cyx3705/2026-003/b-Picture/机械装配图.jpg

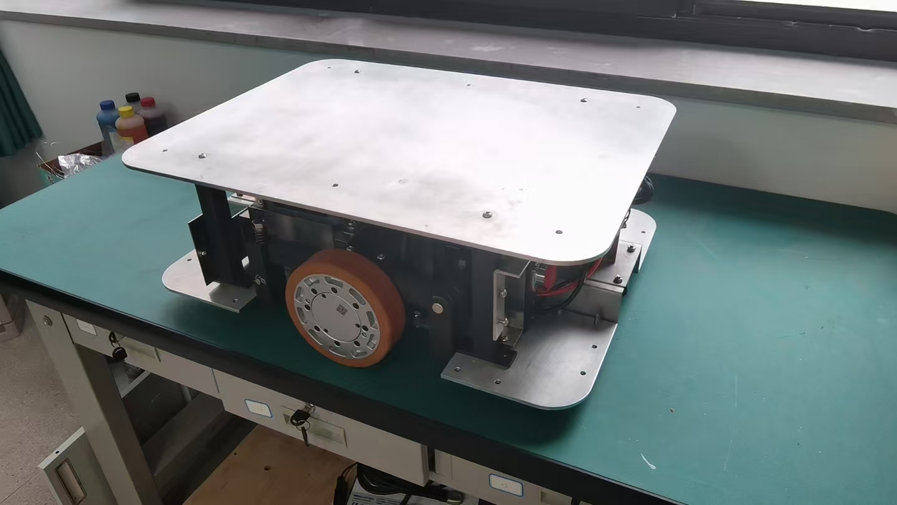
b-Picture/机械装配图.jpg
