cyx3705/2026-003/b-Picture/初次装配图.jpg

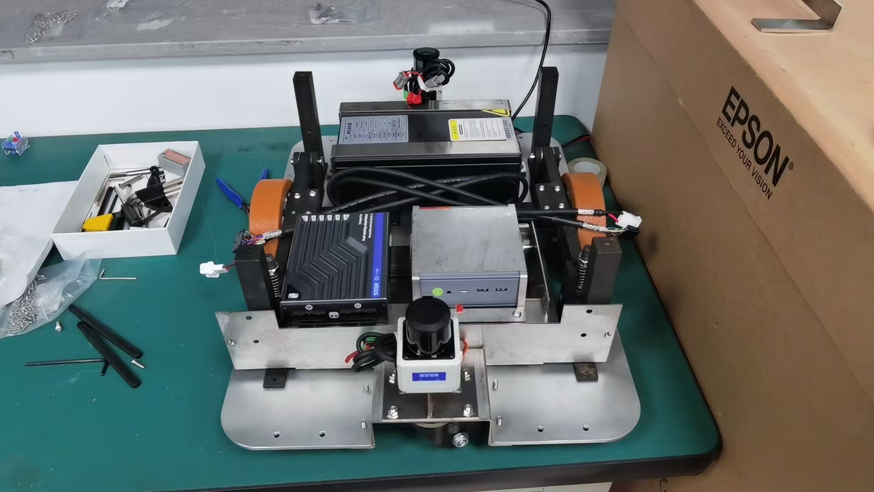
b-Picture/初次装配图.jpg
