cyx3705/2026-003/b-Office/电气接线任务书.md

## 电气接线计划

- 上位机接线图画下 
- 电气缺件BOM统计
- 电气接线接口缺失复核一下
-
