cyx3705/2026-003/b-EPLAN/AGV.edb/Images/2.png

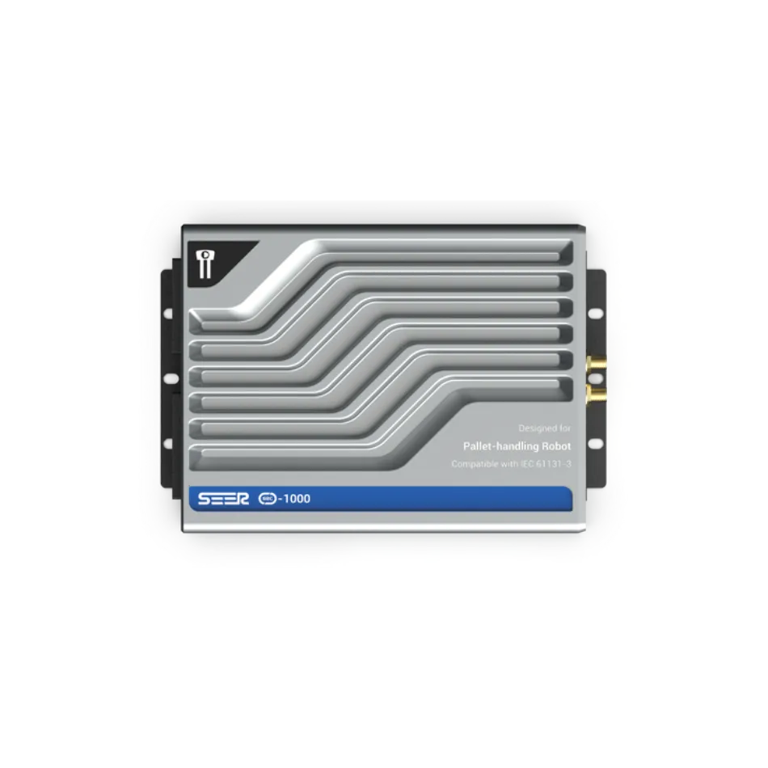
b-EPLAN/AGV.edb/Images/2.png
