cyx3705/2026-003/b-EPLAN/AGV.edb/Images/CRC3000.png

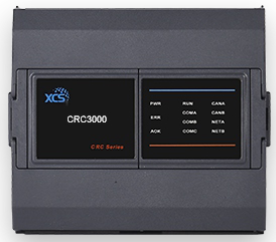
b-EPLAN/AGV.edb/Images/CRC3000.png
