cyx3705/2026-003/b-EPLAN/AGV.edb/Images/EPLAN.jpg

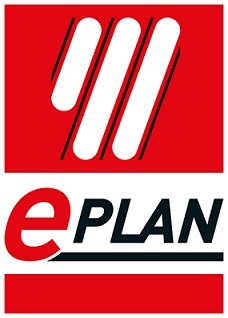
b-EPLAN/AGV.edb/Images/EPLAN.jpg
