cyx3705/2026-003/b-Picture/效果图.png

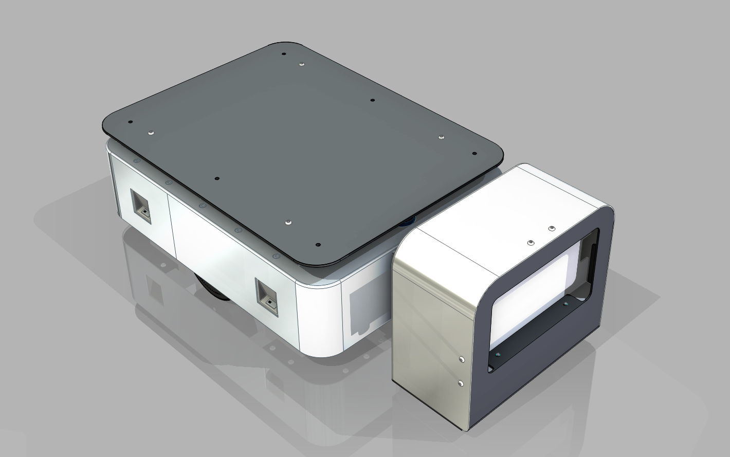
b-Picture/效果图.png
