cyx3705/2026-003/b-Office/BOM表.xlsx

Sheet: Revision History
Revision 版本 | Description 变更描述 | Date 变更日期 | Updated BY 变更人 | Remarks 备注

Sheet: BOM模板
 | Product Name 成品名称 |  | DOC. Number 文件编号 |  | Rev. 版本号 |  |  | Updated BY 更新人 |  | Checked BY 审核人 |  | Approved BY 批准人
 |  |  | BOM-503TWM0203 |  | 1.00
 |  |  |  |  |  |  |  | Date 日期 |  | Date 日期 |  | Date 日期
 |  |  | Initial Date 初版日期
Item 序号 | 文档号 | Description 名称 | Specification 参数描述 | Manufacturer 制造商 |  | Material 材料 | QTY 数量 | Unit 单位 | 是否验收 | Remarks 备注 | EPDM Auto EPDM自动导出 | 细则 | Unit Price 单价(RMB) | Subtotal 合计(RMB)
 |  |  |  | Model No. 型号 | Brand 品牌
1 | 1121 | 1121-底盘主体 |  |  |  | 铝 | 1 | 个 |  | 【淘宝】https://e.tb.cn/h.7ml5gZPPQkVISMc?tk=tJbsUfdvDEd CZ005 |  |  |  | 加工件统一计价
2 | 2122 | 2122-架子 |  |  |  | 钢 | 4 | 个 |  | 【淘宝】https://e.tb.cn/h.7ml5gZPPQkVISMc?tk=tJbsUfdvDEd CZ006 |  |  |  | 加工件统一计价
3 | 1113 | 1113-内六角平圆头螺钉-GBT70.2-2015_M6X16 | M6*16 |  |  |  | 34 | 个 | 对 | 已经购买 |  |  |  | 已经购买
4 | 1312 | 1312-内六角平圆头螺钉-GBT70.2-2015_M6X10 | M6*10 |  |  |  | 14 | 个 | 对 | 已经购买 |  |  |  | 已经购买
5 | 1221 | 1221-前桥 |  |  |  | 钢 | 2 | 个 |  | 【淘宝】https://e.tb.cn/h.7ml5gZPPQkVISMc?tk=tJbsUfdvDEd CZ006 |  |  |  | 加工件统一计价
6 | 1222 | 1222-后桥 |  |  |  | 钢 | 2 | 个 |  | 【淘宝】https://e.tb.cn/h.7ml5gZPPQkVISMc?tk=tJbsUfdvDEd CZ006 |  |  |  | 加工件统一计价
7 | 1213 | 1213-大垫圈 | 10*30*2 |  |  |  | 1 | 组 |  | 【淘宝】假一赔四 https://e.tb.cn/h.7MJcgNyqDq0lb4x?tk=nxhCUgh63I7 CZ193 「304不锈钢垫片圆形加大加厚金属螺丝平垫圈超薄介子华司平垫大全」 点击链接直接打开 或者 淘宝搜索直接打开 |  | 5个 | 1.13元 | 1.13元
8 | 1224 | 1224-减震器 |  |  |  | 钢 | 2 |  |  | 【淘宝】https://e.tb.cn/h.7ml5gZPPQkVISMc?tk=tJbsUfdvDEd CZ006 |  |  |  | 加工件统一计价
9 | 1214 | 1214-小垫圈 |  |  |  |  | 1 | 组 |  | 【淘宝】假一赔四 https://e.tb.cn/h.7MJcgNyqDq0lb4x?tk=nxhCUgh63I7 CZ193 「304不锈钢垫片圆形加大加厚金属螺丝平垫圈超薄介子华司平垫大全」 点击链接直接打开 或者 淘宝搜索直接打开 |  | 5个 | 1.58元 | 1.58元
10 | 1218 | 1218-弹簧 |  |  |  |  | 2 | 个 |  | 【淘宝】退货运费险 https://e.tb.cn/h.7Lm8guSC0Ux0SfB?tk=6AuNUghRivr CZ028 「进口模具弹簧高强度耐高温矩形扁线压缩磨具压簧黄蓝红绿棕褐茶色」 点击链接直接打开 或者 淘宝搜索直接打开 |  |  | 2.73元 | 5.46元
11 | 1225 | 1225-左梁 |  |  |  | 钢 | 1 | 个 |  | 【淘宝】https://e.tb.cn/h.7ml5gZPPQkVISMc?tk=tJbsUfdvDEd CZ006 |  |  |  | 加工件统一计价
12 | 1215 | 1215-平头圆柱销 | 直径10x45 |  |  |  | 1 | 组 |  | 【淘宝】大促价保 https://e.tb.cn/h.7mOc2Ra9KZEBda1?tk=7f3aUfWpWek |  | 5个 | 7.05元 | 7.05元
13 | 1212 | 1212-销 | 直径8 |  |  |  | 1 | 组 |  | 【淘宝】大促价保 https://e.tb.cn/h.7mOc2Ra9KZEBda1?tk=7f3aUfWpWek |  | 5个 | 4.37元 | 4.37元
14 | 1217 | 1217-内六角平圆头螺钉-GBT70.2-2015_M6X20 | M6*20 |  |  |  | 8 | 个 | 对 | 已经购买 |  |  |  | 已经购买
15 | 1218 | 1218-内六角平圆头螺钉-GBT70.2-2015_M5X16 | M5*16 |  |  |  | 8 | 个 | 对 | 已经购买 |  |  |  | 已经购买
16 | 1216 | 1216-1型全金属六角锁紧螺母-GBT6184-2000_M10 | M10 |  |  |  | 2 | 个 | 对 | 已经购买 |  |  |  | 已经购买
17 | 1223 | 1223-右梁 |  |  |  |  | 1 | 个 |  | 【淘宝】https://e.tb.cn/h.7ml5gZPPQkVISMc?tk=tJbsUfdvDEd CZ006 |  |  |  | 加工件统一计价
18 | 1521 | 1521-安装板 |  |  |  |  | 1 | 个 |  | 【淘宝】https://e.tb.cn/h.iJUYQFq3IH6uaaV?tk=fsBd5SyIRlW | 1899-12-31 |  |  | 钣金统一计价
19 | 1515 | 1515-内六角平圆头螺钉-GBT70.2-2015_M4X8 | M4*8 |  |  |  | 6 | 个 | 对 | 已经购买 |  |  |  | 已经购买
20 | 1516 | 1516-内六角平圆头螺钉-GBT70.2-2015_M3X8 | M3*8 |  |  |  | 2 | 个 | 对 | 已经购买 |  |  |  | 已经购买
21 | 1522 | 1522-电脑安装板 |  |  |  |  | 1 | 个 |  | 【淘宝】https://e.tb.cn/h.iJUYQFq3IH6uaaV?tk=fsBd5SyIRlW | 1899-12-31 |  |  | 钣金统一计价
22 | 1577 | 1517-内六角平圆头螺钉-GBT70.2-2015_M6X12 | M6*12 |  |  |  | 18 | 个 | 对 | 已经购买 |  |  |  | 已经购买
23 | 1411 | 1411-底轮 |  |  |  |  | 2 | 个 |  | 【淘宝】大促价保 https://e.tb.cn/h.7MJ4SWmHd5yGuXb?tk=qO5IUghjzTA CZ028 「1寸重型万向轮 低重心尼龙脚轮 2寸双轮轱辘 3寸推车带刹加重轮子」 点击链接直接打开 或者 淘宝搜索直接打开 |  |  | 20.2元 | 40.4元
24 | 1421 | 1421-底轮安装板 |  |  |  |  | 2 | 个 |  | 【淘宝】https://e.tb.cn/h.iJUYQFq3IH6uaaV?tk=fsBd5SyIRlW | 1899-12-31 |  |  | 钣金统一计价
25 | 1621 | 1621-导航雷达安装板 |  |  |  |  | 1 | 个 |  | 【淘宝】https://e.tb.cn/h.iJUYQFq3IH6uaaV?tk=fsBd5SyIRlW |  |  |  | 钣金统一计价
26 | 1713 | 1713-1型非金属嵌件六角锁紧螺母-GBT889.1-2015_M6 | M6 |  |  |  | 8 | 个 | 对 | 已经购买 |  |  |  | 已经购买
27 | 1712 | 1712-内六角平圆头螺钉-GBT70.2-2015_M3X10 | M3*10 |  |  |  | 8 | 个 | 对 | 已经购买 |  |  |  | 已经购买
28 | 1721 | 1721-避障雷达安装板 |  |  |  |  | 1 | 个 |  | 【淘宝】https://e.tb.cn/h.iJUYQFq3IH6uaaV?tk=fsBd5SyIRlW | 1899-12-31 |  |  | 钣金统一计价
29 | 2121 | 2121-安装板 |  |  |  |  | 1 | 个 |  | 【淘宝】https://e.tb.cn/h.iJUYQFq3IH6uaaV?tk=fsBd5SyIRlW | 1899-12-31 |  |  | 钣金统一计价
30 | 2111 | 2111-电箱din导轨 130 |  |  |  |  | 3 | 个 |  | https://item.taobao.com/item.htm?abbucket=11&id=749064062909&ns=1&skuId=5394057435750&xxc=taobaoSearch |  |  | 4.64元 | 13.92元
32 | 121 | 0121-屏幕支架 |  |  |  |  | 1 | 个 |  | 【淘宝】https://e.tb.cn/h.iJUYQFq3IH6uaaV?tk=fsBd5SyIRlW | 1899-12-31 |  |  | 钣金统一计价
34 | 122 | 0122-变压器安装板 |  |  |  |  | 1 | 个 |  | 【淘宝】https://e.tb.cn/h.iJUYQFq3IH6uaaV?tk=fsBd5SyIRlW | 1899-12-31 |  |  | 钣金统一计价
35 | 123 | 0123-变压器安装2 |  |  |  |  | 1 | 个 |  | 【淘宝】https://e.tb.cn/h.iJUYQFq3IH6uaaV?tk=fsBd5SyIRlW | 1899-12-31 |  |  | 钣金统一计价
36 | 116 | 0116-内六角平圆头螺钉-GBT70.2-2015_M5X12 | M5*12 |  |  |  | 6 | 个 | 对 | 已经购买 |  |  |  | 已经购买
39 | 125 | 0125-电器架 |  |  |  |  | 1 | 个 |  | 【淘宝】https://e.tb.cn/h.iJUYQFq3IH6uaaV?tk=fsBd5SyIRlW | 1899-12-31 |  |  | 钣金统一计价
40 | 126 | 0126-miniPC电源 | 19V10A |  |  |  | 1 | 个 |  | https://item.taobao.com/item.htm?id=553788314091&last_time=1768143784&skuId=4092429570913&upStreamPrice=3915 |  |  | 63.5元 | 63.5元
41 | 127 | 0127-变压器 | 24V6.35A |  |  |  | 1 | 个 |  | https://www.jndz021.com/dc/132（淘宝没有货源，在官网上采购）
42 | 128 | 0128-屏幕电源 | 24V15A |  |  |  | 1 | 个 |  | https://detail.tmall.com/item.htm?ali_trackid=318_b1e44a53e68312397166bdb38376f31f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 |  |  | 83元 | 83元
43 | 129 | 0129-接触器 | 12A, 24 V |  |  |  | 1 | 个 |  | https://item.taobao.com/item.htm?id=684180101591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 |  |  | 160元 | 160元
44 | 130 | 0130-空开 |  |  |  |  | 1 | 个 |  | https://item.taobao.com/item.htm?id=885444239746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 |  |  | 231元 | 231元
45 | 131 | 0131-接线端子 | PT2.5-QUATTRO灰色 |  |  |  | 50 | 个 |  | https://item.taobao.com/item.htm?ali_trackid=282_75421c7a1bf937df626379b8de81db84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 |  |  | 118元 | 118元
46 | 132 | 0132-焊枪（一套） |  |  |  |  | 1 | 个 |  | https://detail.tmall.com/item.htm?ali_trackid=282_0e3224a199436b146fadd1013df40d50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 |  |  | 269元 | 269元
47 | 133 | 0133-电池 | 48V20AH |  |  |  | 1 | 个 |  | 电池客服：13662632158 |  |  |  | 还未咨询
48 | 134 | 0134-仙工控制器 |  |  |  |  | 1 | 个 | 对 | 已经购买 |  |  |  | 已经购买
49 | 135 | 0135-激光雷达 |  |  |  |  | 1 | 个 | 对 | 已经购买 |  |  |  | 已经购买
50 | 136 | 0135-导航雷达 |  |  |  |  | 1 | 个 | 对 | 已经购买 |  |  |  | 已经购买
50 | 1312 | 1312-电机 |  |  |  |  | 2 | 个 | 对 | 已经购买 |  |  |  | 已经购买
50 | 3129 | 3129-顶板 |  |  |  |  | 1 | 个 |  | 【淘宝】https://e.tb.cn/h.7ml5gZPPQkVISMc?tk=tJbsUfdvDEd CZ006 |  |  |  | 加工件统一计价
 |  |  |  |  |  |  |  |  |  |  |  |  | 钣金件合计 | 360元
 |  |  |  |  |  |  |  |  |  |  |  |  | 加工件合计
