cyx3705/2026-003/b-Office/加工件遇到的问题.xlsx

序号 | 零件 | 问题 | 个数 | 交由谁解决 | 解决的进度 | 计划的时间
1 | 电机连接梁 | 电机连接孔过小 | 2 | CYX,SSY | 已经完成 | 6、10
2 | 电池钢带 | 连接孔过小 | 2 | CYX | 已经完成 | 6、9
3 | 弹簧 | 型号过小 | 2 | CYX | 等待购买 | 6.14
4 | 垫片 | 型号过大 | 2 | CYX | 等待购买 | 6.14
5 | 雷达支架 | 钣金加工误差 | 2 | CYXSSY | 修改模型 | 6.14
6 | 电气导轨 | 型号过小 | 4 | SSY | 等待购买 | 6.14
7 | 底轮 | 型号错误 | 2 | SSY | 等待购买 | 6.14
8 | 电池充电桩设计 | 官方的过贵自己设计 | 1 | 等待电气同学这个对于CHH太难 | 等待中
