cyx3705/2026-003/b-Module-GE/0121-屏幕支架.stp

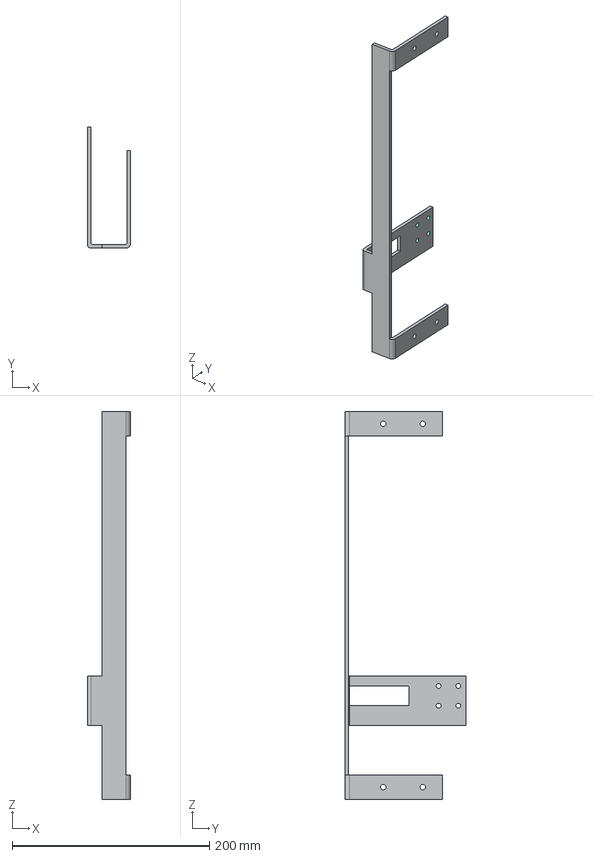
[picture p7: CAD file, 2026-09-21]
b-Module-GE/0121-屏幕支架.stp
44.0 x 123.0 x 393.0 mm
