cyx3705/2026-003/b-Module-SE/0000-AGV/0000-1226.stp

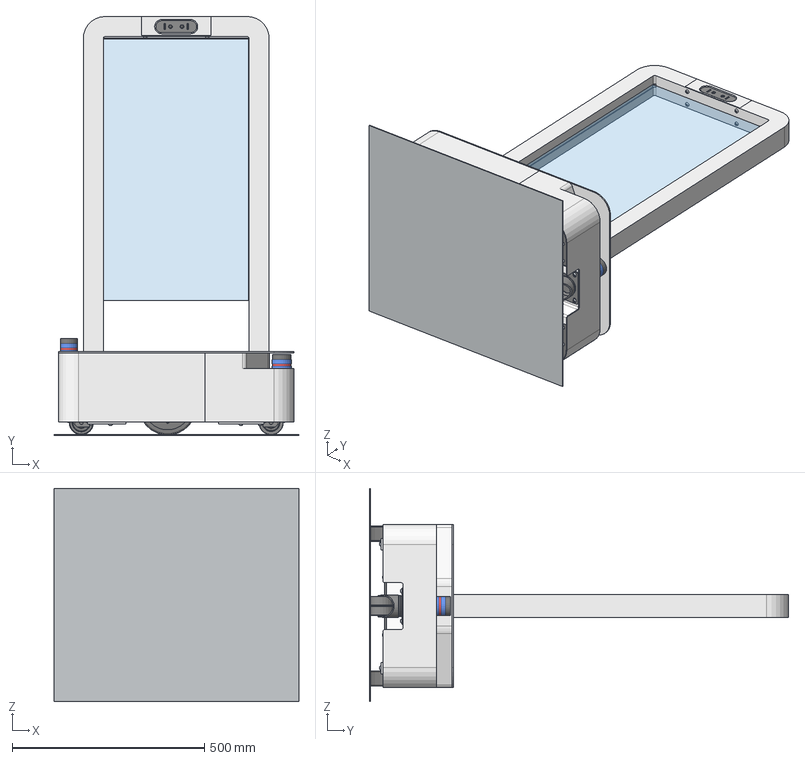
[picture p8: CAD file, 2026-09-21]
b-Module-SE/0000-AGV/0000-1226.stp
635.9 x 1088.5 x 554.6 mm
1121-底盘洏涓讳綋
2122-架跺瓙 x 4
1113-ÄÚÁù½ÇÆ½Ô²Í·ÂÝ¶¤-GBT70.2-201å46 x 18
ﾂﾖｮ x 4
ﾉﾏh x 2
笢潔 x 2
1421-���ְ�安装板 x 2
1412-内六角平圆头螺钉-GBT70.2-201 x 16
1311-萇
1312-内六角平圆头螺钉-GBT70.2-201 x 8
307091485SSㄗiWMC06006-00850-A150-MBDTㄘ-V1.0 x 2
1213-湮菜 x 4
1222-綴Э‘ x 2
1221-ǰntationRefs x 2
1217-内六角平圆头螺钉-GBT70.2-201蝙  x 8
1212-种 x 2
1215-ƽͷԲs x 2
1218-ÄÚÁù½ÇÆ½Ô²Í·ÂÝ¶¤-GBT70.2-201å76 x 8
1224-¼õÕðœ‡å™¨.par:1 x 2
1225-酘
1214-Ð¡µæ4ú  x 4
1218-粟
1216-1ﾐﾍﾈｫｽﾇﾋﾝﾄｸ-GBT618帙# x 2
1223-右虫
1001-華
1521-假蚾
1512-SRC-1X00-CN
1513-音冲搷
1516-内六角平圆头螺钉-GBT70.2-20T x 2
1511-曹揤
1514-ｼｫﾄｦｿﾍ7840hsﾎ｢
1515-ÄÚÁù½ÇÆ½Ô²Í·ÂÝ¶¤-GBT70.2-20à-¾7 x 6
1522-电脑安u亯[艌g
1517-内六角平圆头螺钉-GBT70.2-201鸺  x 4
1621-导航雷达
1611-絳瑤
1713-1ﾐﾍｷﾇｽｶｼﾁﾇﾋﾝﾄｸ-GBT88 x 8
1712-内六角平圆头螺钉-GBT70.2-201 x 6
2121-ｰｲﾗｰYｩ 
2111-电箱din导轨 x 2
2115-内六角平圆头螺钉-GBT70.2-201T_BODY_ID x 6
2125-PT2.5-QUATTRO灰色（万特弗 x 12
2125-PT2.5-QUATTRO灰色隔断板（万R x 6
SB105175_3D-SOFTWARE_COLOUR
2119-諾羲 fs x 2
3121-前外壳钣金
3122-綴俋褲
3116-IZE0168扜砉
3111-内六角平圆头螺钉-GBT70.2-201 x 4
3118-ﾄﾚﾁﾇﾆｽﾔｲﾍｷﾂﾝｶ､-GBT70.2-201kﾖ x 4
3117-内六角平圆头螺钉-GBT70.2-20T x 2
3124-扜砉芛
3123-奻俋
1721-避障雷达
1711-避障殰闆疯揪
0112-屏幕外 
0111-そ
0121-ﾆﾁﾄｻｹ墓髪譫ｶ.par:1
0118-内六角平圆头螺钉-GBT70.2-201 x 2
0116-ﾄﾚﾁﾇﾆｽﾔｲﾍｷﾂﾝｶ､-GBT70.2-201會 x 6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
