cyx3705/2026-003/b-Module-SE/1000-底盘/1200-悬挂/1210-标准件/1312-电机/iWMC05606-00850-A150-MBDT-L.STEP

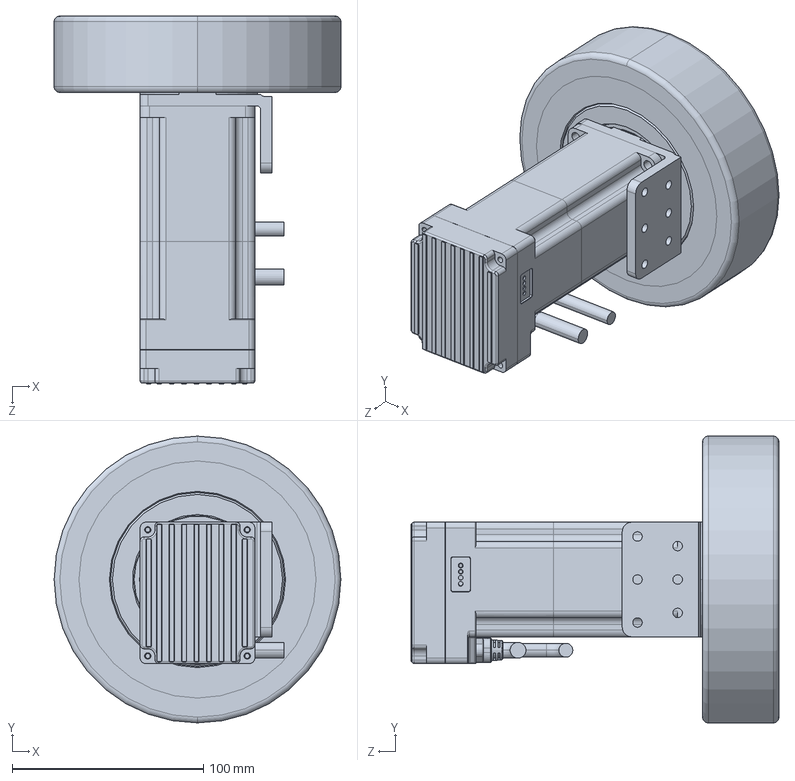
[picture p9: CAD file, 2026-09-21]
b-Module-SE/1000-底盘/1200-悬挂/1210-标准件/1312-电机/iWMC05606-00850-A150-MBDT-L.STEP
150.0 x 150.0 x 192.5 mm
