cyx3705/2026-003/b-Module-GE/1321-钢带.stp

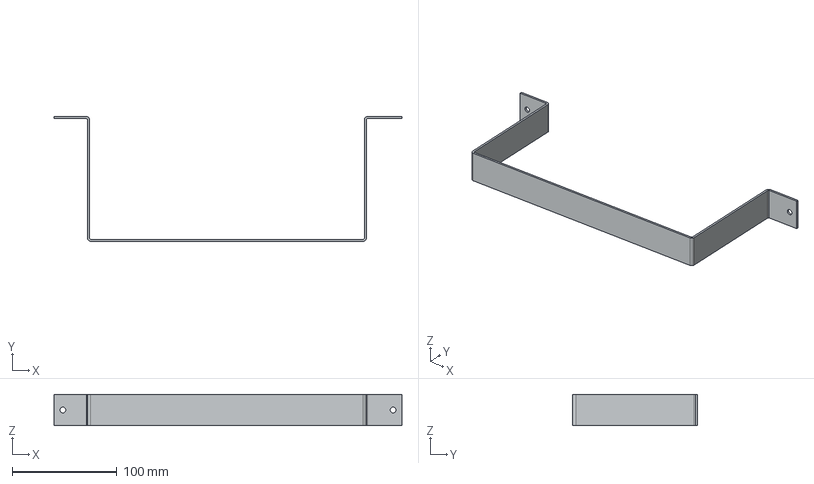
[picture p10: CAD file, 2026-09-21]
b-Module-GE/1321-钢带.stp
332.0 x 119.0 x 30.0 mm
