cyx3705/2026-003/b-Module-SE/0200-充电桩/0210-标准件/0214-横向刷快/3237440921横向刷块.STEP

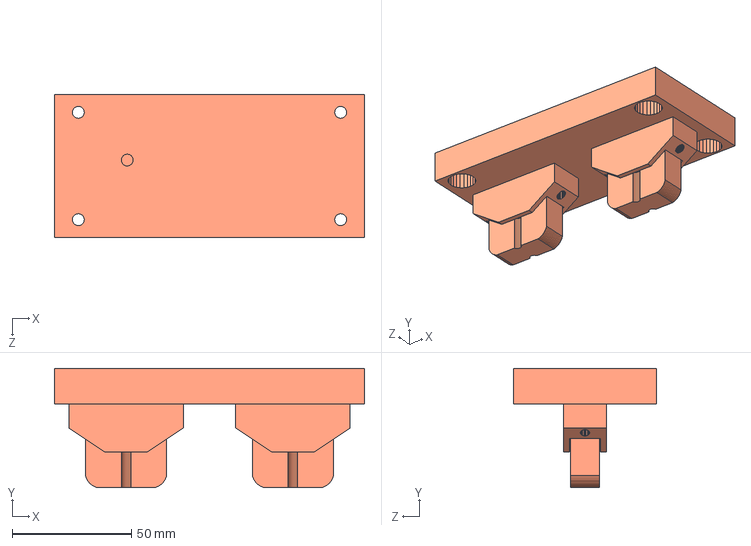
[picture p11: CAD file, 2026-09-21]
b-Module-SE/0200-充电桩/0210-标准件/0214-横向刷快/3237440921横向刷块.STEP
130.0 x 50.0 x 60.0 mm
