cyx3705/2026-003/(list of files, cad)

Other CAD files:
b-Module-2D/3129-刷版固定件.dwg
b-Module-2D/1224-减震器 (改2).dwg
b-Module-2D/0121-屏幕支架.dwg
b-Module-2D/1122-架子（修改）（修改4）.dwg
b-Module-2D/1221-前桥（改2）.dwg
b-Module-2D/1222-后桥.dwg
b-Module-2D/1235-左梁（改2）.dwg
b-Module-2D/1223-右梁（改2）.dwg
b-Module-2D/3129-顶板.dwg
b-Module-2D/1131-底盘主体（改2）.dwg
