cyx3705/2026-003/(commit log)

2026-05-09 feat: 添加2025-004-迎宾机器人 项目核心资料
2026-05-12 feat: 初始化 2026-003-中AGV小车 项目
2026-05-27 更新备份内容 - 2026-05-27 22:21
2026-05-27 更新 README.md - 2026-05-28 01:27
2026-06-05 添加遇到的问题的的跟进表格
2026-06-23 一键推送更新,将原数字标号统一改为b
2026-07-06 一键推送更新
2026-08-12 一键推送更新 管理规则
    [0000-1227.cfg, 3100-前后外壳.cfg]
2026-08-14 chore: 迁移到 HistoryClio 后的工作区基线
    分仓库迁移遗留在工作区的改动一次性落库，并清理模板带下来的 Unused 脚手架。
    - 删除 Unused/（3 个已入库文件，主要是 b-EPLAN 与占位 READEME）；内容仍可从历史取回。
    - 其余为迁移过程产生的工作区差异，未逐条审阅业务含义。
    本次由 Claude 代为提交，用于把分仓库后的工作树归零。
    [0000-0116.cfg, 0000-0327.cfg, 0000-0526.cfg, 0000-1212.cfg, 0000-1217.cfg, 0000-1217B.cfg, 0000-1218.cfg, 0000-1218B.cfg]
2026-08-17 对齐 LFS 指针规则：137 条扩展名通配 -> 301 条精确路径
    按扩展名批量套 LFS 是 11GB 占用与推送被拒的根因。现存指针逐条保留以免失效；
    新文件不再自动进 LFS，只有超过 GitHub 100MB 硬限时才由提交链路逐个征求同意。
2026-09-19 添加电气任务书
2026-09-21 LFS 修复：301 个不足 100MB 的文件转回普通入库（第 1/1 批）
    [0000-0116.cfg, 0000-0327.cfg, 0000-0526.cfg, 0000-1212.cfg, 0000-1217.cfg, 0000-1217B.cfg, 0000-1218.cfg, 0000-1218B.cfg]
